Wojttekja/JARVIS-LEDs/cad/remote-case/tolerance-test/t1_switch_plate_test.3mf

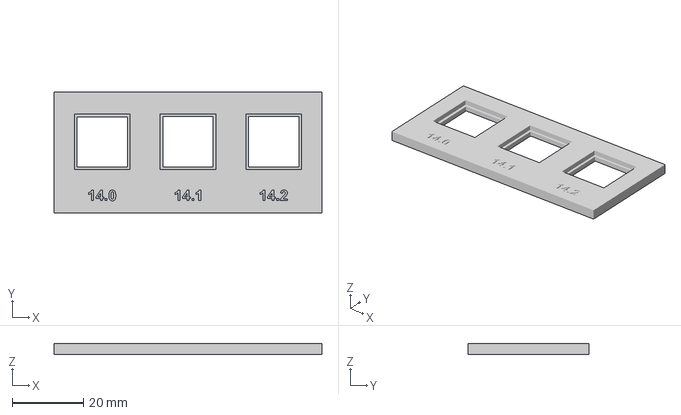
[picture p1: CAD file, 2026-10-31]
cad/remote-case/tolerance-test/t1_switch_plate_test.3mf
75.0 x 34.0 x 3.00 mm
