Wojttekja/JARVIS-LEDs/cad/remote-case/tolerance-test/t4_knob_shaft_test.3mf

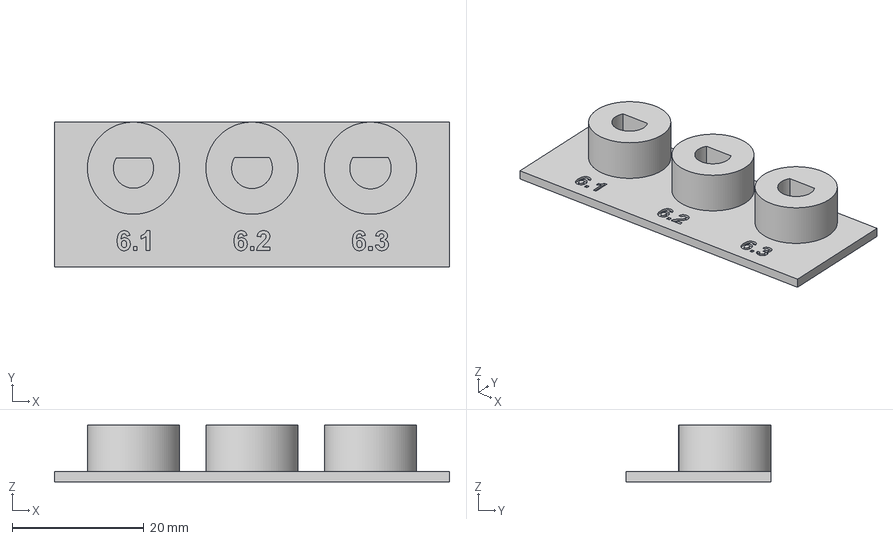
[picture p2: CAD file, 2026-10-31]
cad/remote-case/tolerance-test/t4_knob_shaft_test.3mf
60.0 x 22.0 x 8.60 mm
