Wojttekja/JARVIS-LEDs/cad/remote-case/tolerance-test/t2_panel_and_fastener_test.3mf

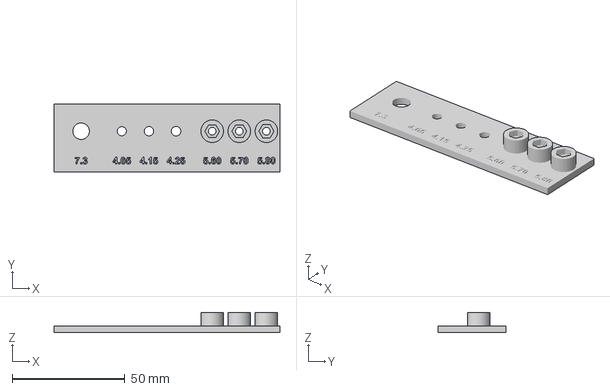
[picture p3: CAD file, 2026-10-31]
cad/remote-case/tolerance-test/t2_panel_and_fastener_test.3mf
100.0 x 30.0 x 9.00 mm
