Wojttekja/JARVIS-LEDs/cad/remote-case/tolerance-test/t5_pico_usb_corner_test.3mf

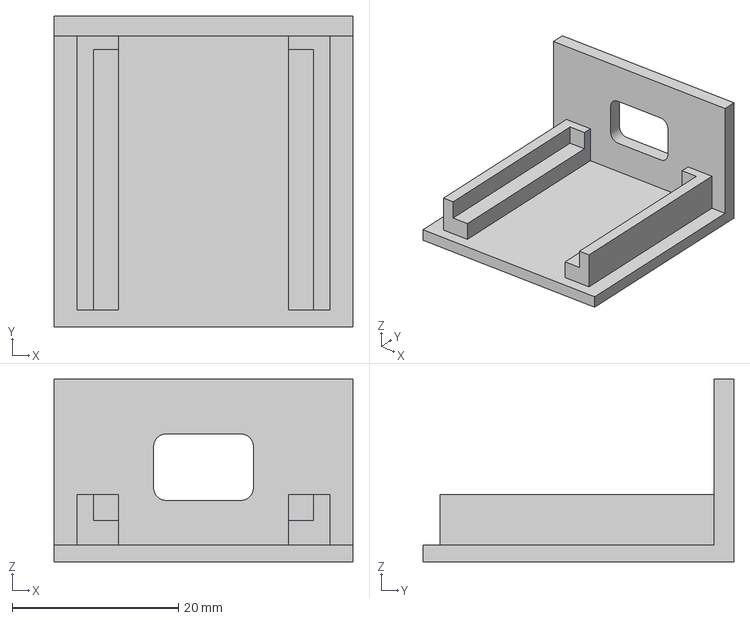
[picture p4: CAD file, 2026-10-31]
cad/remote-case/tolerance-test/t5_pico_usb_corner_test.3mf
36.0 x 37.4 x 22.0 mm
