Wojttekja/JARVIS-LEDs/cad/remote-case/tolerance-test/t3_keycap_stem_test.3mf

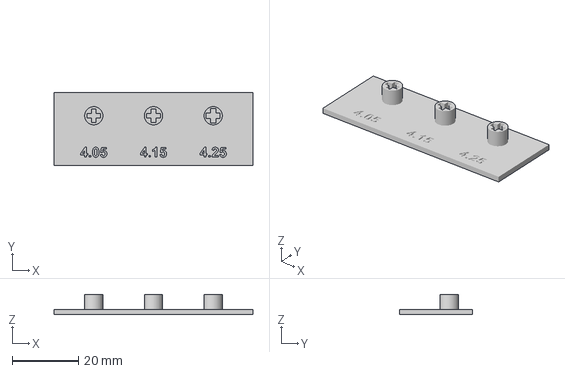
[picture p5: CAD file, 2026-10-31]
cad/remote-case/tolerance-test/t3_keycap_stem_test.3mf
60.0 x 22.0 x 6.10 mm
