Wojttekja/JARVIS-LEDs/cad/remote-case/tolerance-test/t6_light_pipe_test.3mf

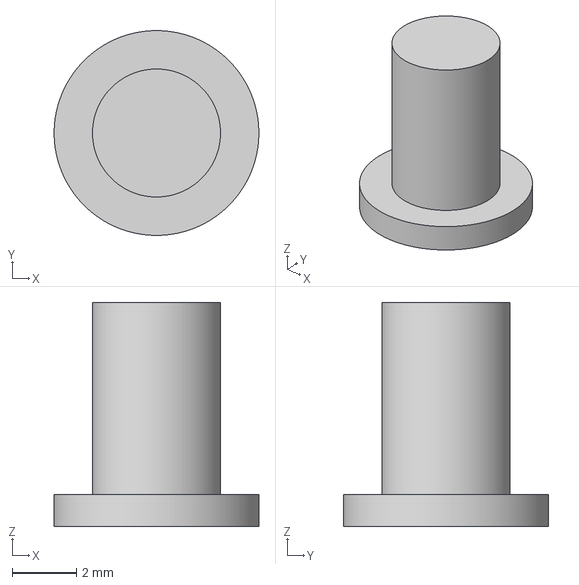
[picture p6: CAD file, 2026-10-31]
cad/remote-case/tolerance-test/t6_light_pipe_test.3mf
6.40 x 6.40 x 7.00 mm
