Wojttekja/JARVIS-LEDs/steps/01_blink/main.c

// Step 1: hello world - blink the onboard LED (GP25 on the original Pico).
#include "pico/stdlib.h"

int main(void) {
    const uint led = PICO_DEFAULT_LED_PIN;  // GP25
    gpio_init(led);
    gpio_set_dir(led, GPIO_OUT);

    while (true) {
        gpio_put(led, 1);
        sleep_ms(250);
        gpio_put(led, 0);
        sleep_ms(250);
    }
}
