Wojttekja/JARVIS-LEDs/(commit log)

2026-10-31 Pico LED remote: working remote + receiver firmware
    Two Raspberry Pi Picos with nRF24L01+ radios controlling a 12 V WS2811
    strip (48 pixels, BRG).
    - common/: nRF24 driver (250 kbps, ch 108, auto-ACK + ACK payloads),
    shared protocol (full-state messages, receiver status in ACKs),
    HSV helpers, flash storage, board identification
    - remote/: 3x3 keys + KY-040 knob (half-step decoder), state sync with
    receiver, saved color slots, tunables in config.h
    - receiver/: PIO+DMA WS2811 driver, effects (solid, rainbow, fire,
    breathe, nebula), fades/crossfades, sleep timer, state persistence,
    watchdog, health reporting
    - steps/: bring-up test programs 01-07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
2026-10-31 Receiver: self-repair the nRF24 when it loses its setup
    A supply glitch can reset the radio into power-down while the Pico keeps
    running, so the watchdog never fires and the receiver goes deaf until
    replugged. Check the radio registers every second and set it up again if
    they're gone or if no packet arrived for 10 s. Report it to the remote via
    RECEIVER_FLAG_RADIO_REINIT; receiver serial 'k' simulates the glitch.
    [config.h, main.c, nrf24.c, nrf24.h, protocol.h]
2026-10-31 Add case-design prompts and remote case tolerance test prints
    [t1_switch_plate_test.3mf, t2_panel_and_fastener_test.3mf, t3_keycap_stem_test.3mf, t4_knob_shaft_test.3mf, t5_pico_usb_corner_test.3mf, t6_light_pipe_test.3mf]
